Aus3D/z-probe/Resources/v130_top.PNG

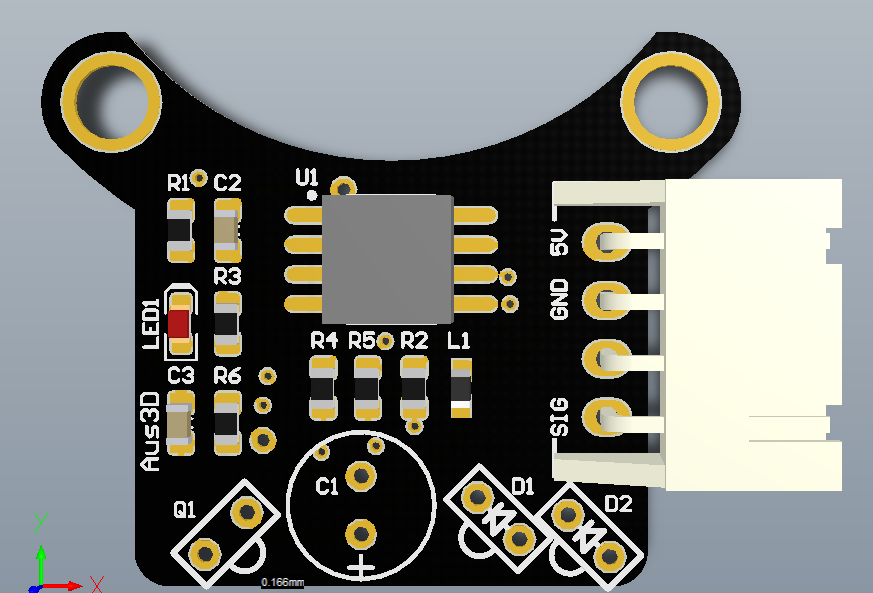
Resources/v130_top.PNG
