Aus3D/z-probe/Resources/v140_top.PNG

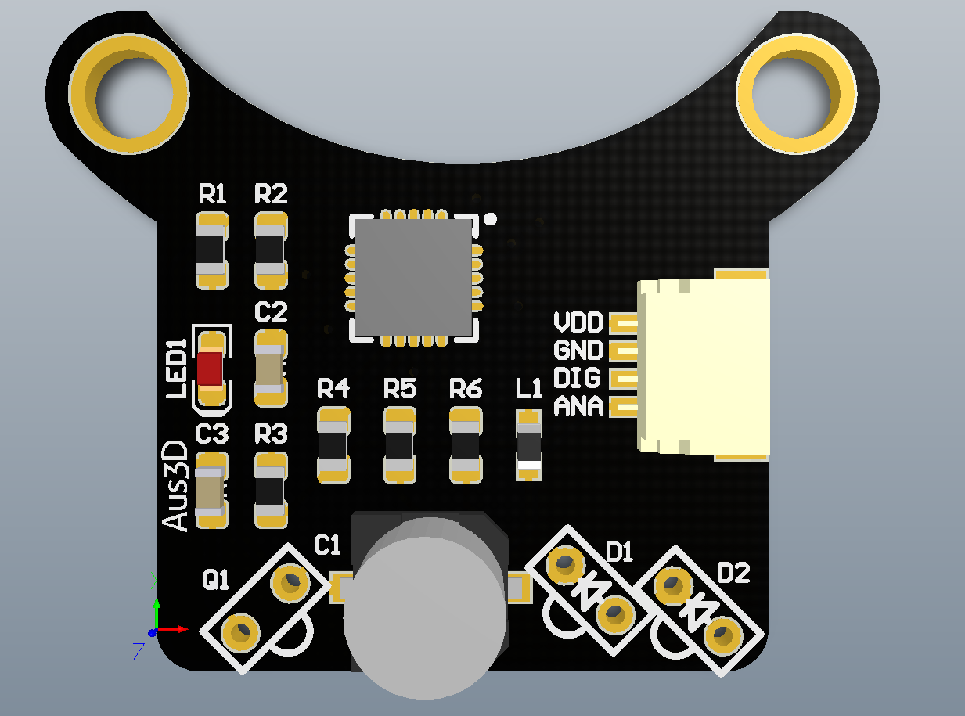
Resources/v140_top.PNG
