Aus3D/z-probe/Resources/v130_bottom.PNG

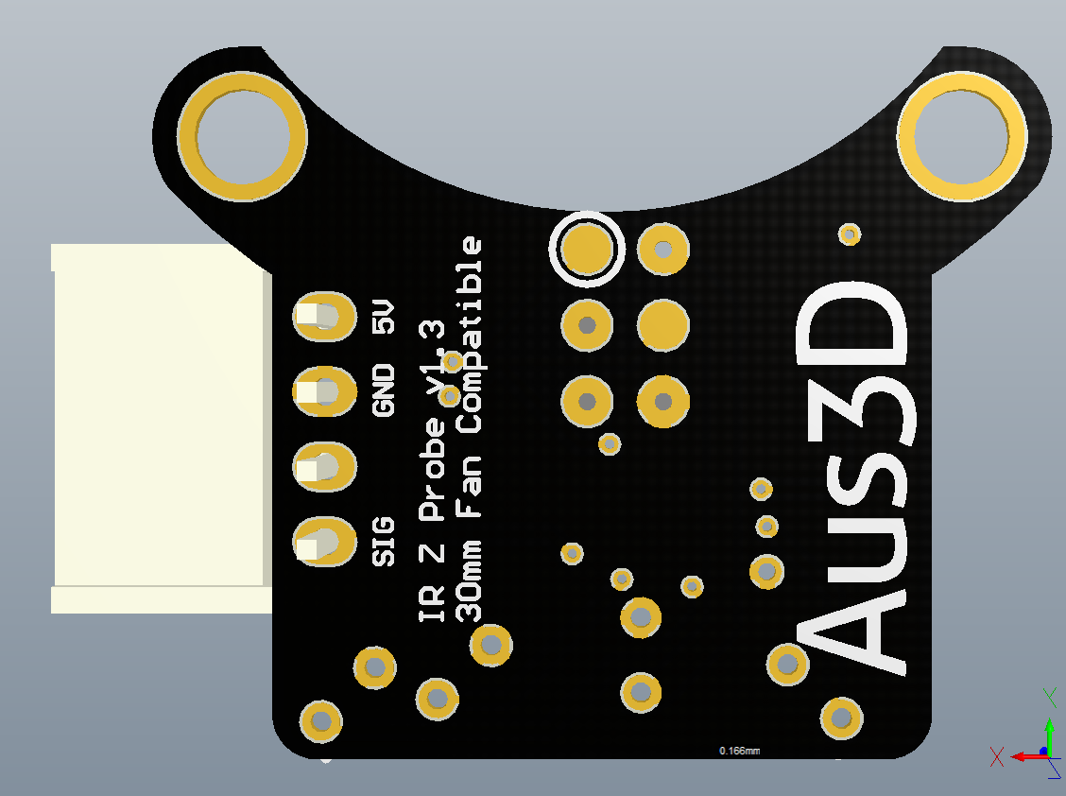
Resources/v130_bottom.PNG
