Aus3D/z-probe/Source/Outputs/irprobe_v141_BOM.xlsx

Designator | Description | Value | Manufacturer 1 | Manufacturer Part Number 1 | Quantity | Substitute | Notes | Supplier 1 | Supplier Part Number 1
C1 | Capacitor THT Electrolytic 20% 16V 100uF | 100u | Kemet | ES5107M016AE1EA | 1 | Approved Sub OK | 5.2-6.0mm Diameter, 5.0-6.5mm Height, 2.5mm pin spacing, 10V or 16V | Digi-Key | 399-6648-1-ND
C2 | Capacitor SMD Cer 100nF 10% 50V X7R 0603 | 100n | AVX Corporation | 06035C104KAT2A | 1 | Approved Sub OK |  | Digi-Key | 478-5052-1-ND
C3 | Capacitor SMD Cer 1nF 10% 100V X7R 0603 | 1n | Murata Electronics North America | GCM188R72A102KA37D | 1 | Approved Sub OK |  | Digi-Key | 490-4780-1-ND
D1, D2 | GL480E |  | Sharp Microelectronics | GL480E00000F | 2 | Approved Sub OK |  | Digi-Key | 425-1940-5-ND
L1 | SMD-Multilayer Inductor WE-MI, L = 1.00 µH | 1uH | TDK Corporation | MLZ1608A1R0M | 1 | Approved Sub OK |  | Digi-Key | 445-3163-2-ND
LED1 | LED 0603 SMD Hyper Red 630nm 220mcd 20mA |  | Kingbright Company LLC | APT1608SURCK | 1 | Approved Sub OK |  | Digi-Key | 754-1123-1-ND
P1 | JST-SH PCB connector side-entry |  | JST Sales America Inc. | SM04B-SRSS-TB(LF)(SN) | 1 | Approved Sub OK |  | Digi-Key | 455-1804-1-ND
Q1 | SFH3100F |  | OSRAM Opto Semiconductors Inc. | SFH 3100 F | 1 | Approved Sub OK |  | Digi-Key | 475-1445-ND
R1 | Resistor SMD chip 330 Ohm 0.1W 5% 0603 | 330R | Vishay Dale | CRCW0603330RJNEA | 1 | Approved Sub OK |  | Digi-Key | 541-330GCT-ND
R2 | Resistor SMD chip 6.8k Ohm 0.1W 5% 0603 | 6K8 | Yageo (https://octopart-clicks.com/click/altium?manufacturer=Panasonic%20Electronic%20Components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) | RC0603JR-072K2L (https://octopart-clicks.com/click/altium?manufacturer=Panasonic%20Electronic%20Components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) | 1 | Approved Sub OK |  | Digi-Key | 311-6.8KGRDKR-ND
R3 | Resistor SMD chip 10k Ohm 0.1W 1% 0603 | 10K | Yageo | RC0603FR-0710KL | 1 | Approved Sub OK |  | Digi-Key | 311-10.0KHRCT-ND
R4 | Resistor SMD chip 12k Ohm 0.1W 1% 0603 | 12K | Yageo | RC0603FR-0710KL | 1 | Approved Sub OK |  | Digi-Key | 311-12.0KHRCT-ND
R5 | Resistor SMD chip 150R Ohm 0.1W 5% 0603 | 150R | Yageo (https://octopart-clicks.com/click/altium?manufacturer=Panasonic%20Electronic%20Components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) | RC0603JR-072K2L (https://octopart-clicks.com/click/altium?manufacturer=Panasonic%20Electronic%20Components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) | 1 | Approved Sub OK |  | Digi-Key | 311-150GRDKR-ND
R6 | Resistor SMD chip 130R Ohm 0.1W 5% 0603 | 130R | Yageo (https://octopart-clicks.com/click/altium?manufacturer=Panasonic%20Electronic%20Components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) | RC0603JR-072K2L (https://octopart-clicks.com/click/altium?manufacturer=Panasonic%20Electronic%20Components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) | 1 | Approved Sub OK |  | Digi-Key | 311-130GRDKR-ND
U1 | 8-bit AVR Microcontroller, 20MHz, 1.8-5.5V, 4KB Flash, 256 Bytes EEPROM, 256 Bytes SRAM, 20-pin MLF, Industrial Grade (-40°C to 85°C), Pb-Free |  | Atmel | ATTINY44A-MU | 1 | Approved Sub OK |  | Digi-Key | ATTINY44A-MU-ND
