Aus3D/z-probe/Resources/3D/irprobe_v140_model.step

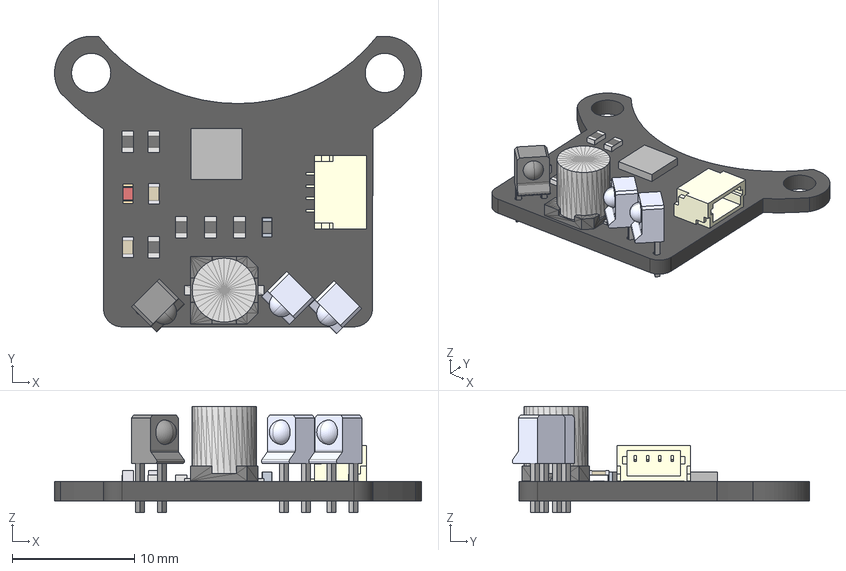
[picture p4: CAD file, 2016-09-13]
Resources/3D/irprobe_v140_model.step
30.0 x 24.3 x 8.69 mm
Board
RES_0603_(1608_metric) x 6
SM04B-SRSS-TB_RGB13434879
through-hole-side-LED_RGB5263440
LED_0603_APT1608_RED
Lötende x 2
Extruded
through-hole-side-LED x 2
CAP_0603 x 2
CAP_EEFK_C
