Aus3D/z-probe/Resources/3D/irprobe_v130_prog_cradle.sldprt

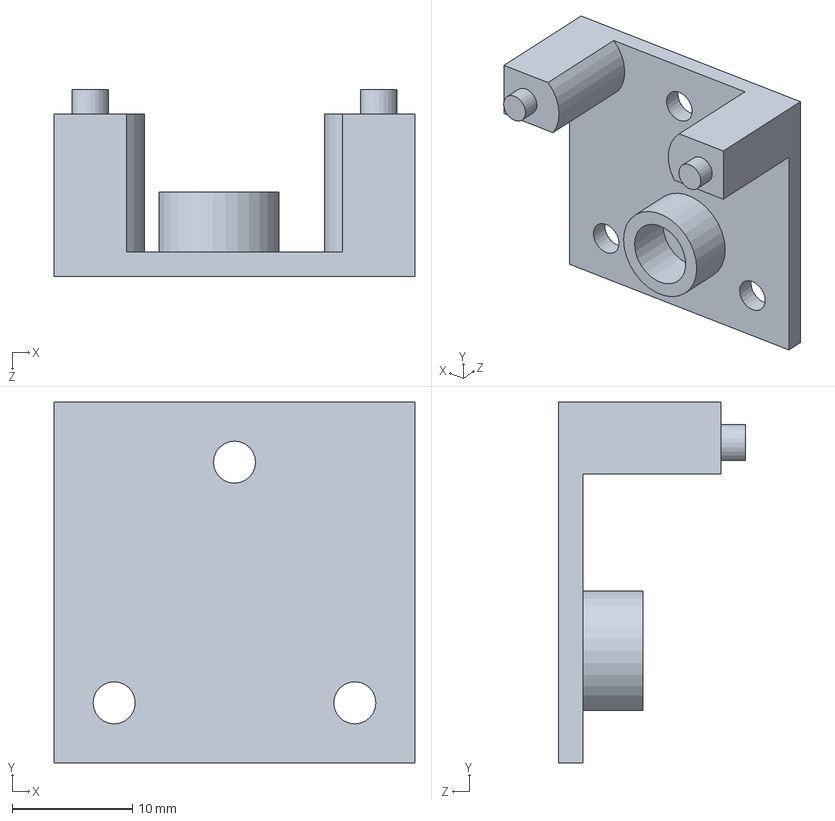
[picture p5: CAD file, 2015-10-24]
Resources/3D/irprobe_v130_prog_cradle.sldprt
30.0 x 30.0 x 15.5 mm
