Aus3D/z-probe/(list of files, cad)

Other CAD files:
Resources/3D/irprobe_v130_prog_cradle.STL
Resources/3D/irprobe_v140_model.STL
