Aus3D/z-probe/schematic.pdf

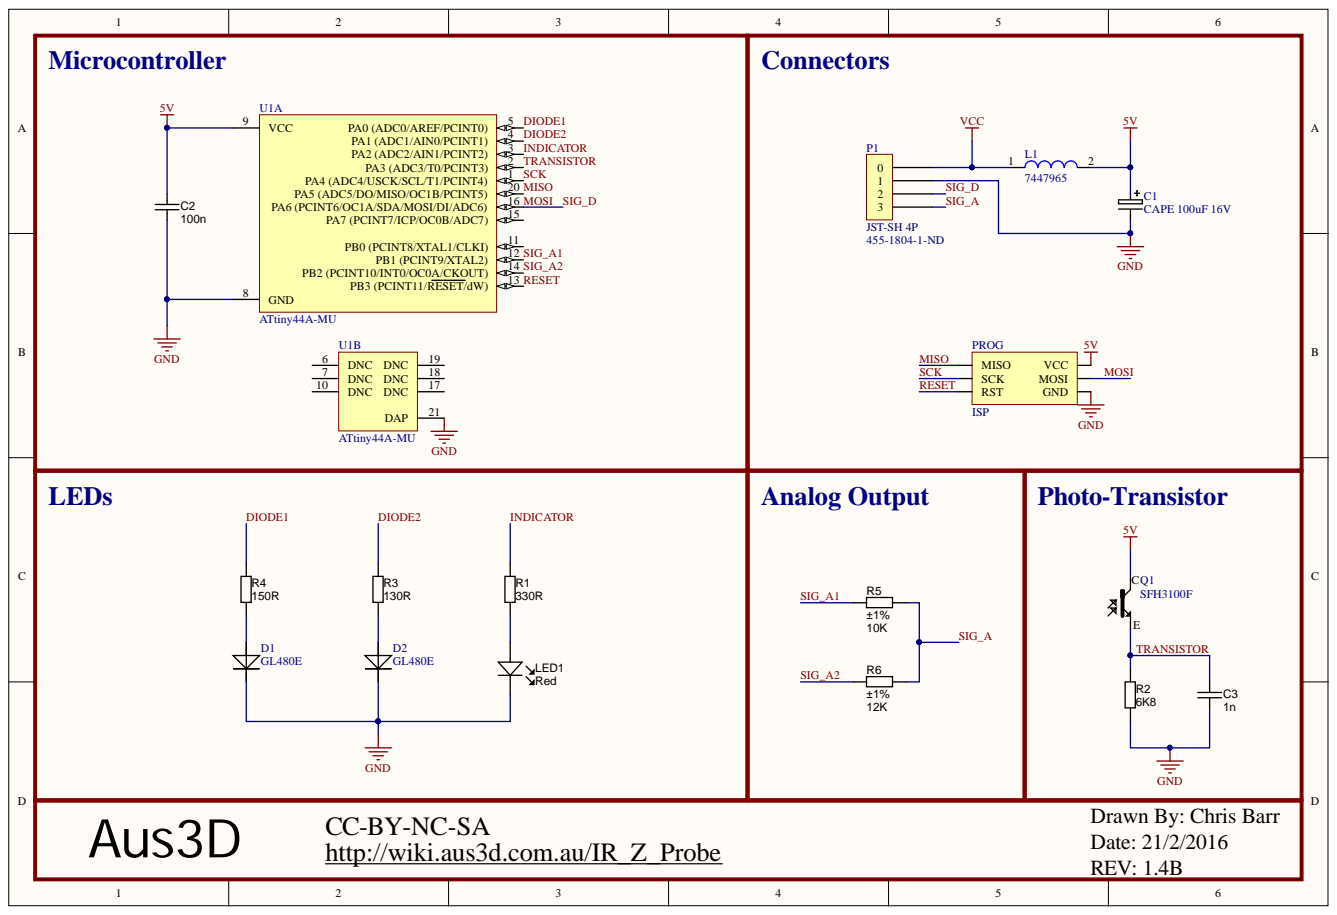
[picture p6: page 1]

http://wiki.aus3d.com.au/IR_Z_Probe
