Aus3D/z-probe/(list of files, drawings)

Other design files:
Source/abl_board.PrjPcb
Source/ir_probe.PcbDoc
Source/ir_probe.PrjPcb
Source/ir_probe.SchDoc
