Aus3D/z-probe/(commit log)

2015-09-12 Initial Commit
    Moving z-probe from Mark2 repository to stand alone repository. Was
    getting tricky to track changes, and things were getting messy.
    [PCB4-2.SLDPRT, PCB4-2.step, PCB4-21.SLDPRT, abl_board.PrjPcb, board1.SchDoc, mini-20mm.PcbDoc, mini-30mm-fan.PcbDoc]
2015-10-24 Added old files
    Added legacy files from development
    [ExtruderZProbe.PrjPcb, IR-Z-Probe.PrjPcb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]
2016-02-19 Work on 1.4A
    Technically ready for manufacture, but I want to play around with it a bit more first. Electrolytic capacitor swapped to SMD, new capacitor saves on height and decreases profile of board. This should make it easier to mount and not worry about collisions etc., board is less likely to be damaged.
    [abl_board.PrjPcb, board1.SchDoc, mini-20mm.PcbDoc, mini-30mm-fan.PcbDoc, z-probe.SchDoc]
2016-02-21 Schematic + PCB draft
    Swapped to ATtiny44A and JST-SH connector.
    [mini-30mm-fan.PcbDoc, z-probe.SchDoc]
2016-02-24 Production Ready
    Files for first batch of updated design.
    [1-4-mini-30mm-fan-BOM-updated.xlsx, 1-4-mini-30mm-fan-pick-place.csv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]
2016-09-13 3D models
    Update PCB with models for most components
    [aus3d-ir-z-probe.STL, aus3d-ir-z-probe.step, mini-30mm-fan.PcbDoc, mini-30mm-fan.step, mini-30mm-fan1.STL]
2019-02-16 Add v1.41 files
    [1-4-mini-30mm-fan-BOM-updated.xlsx, abl_board.PrjPcb, mini-30mm-fan.PcbDoc, v141-zprobe-bom.xlsx, v141-zprobe-pickplace.csv, z-probe.SchDoc]
2019-02-16 Tidying repository
    [ExtruderZProbe.PrjPcb, IR-Z-Probe.PrjPcb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]
2019-02-16 Further tidying
    [ir_probe.PcbDoc, ir_probe.PrjPcb, ir_probe.SchDoc, v130-zprobe-bom.xlsx, v130-zprobe-pickplace.csv, v140-zprobe-bom.xlsx, v140-zprobe-pickplace.csv, v141-zprobe-bom.xlsx]
2019-02-16 Rename output files
    For consistency with other projects
    [irprobe_v130_BOM.xlsx, irprobe_v130_pickplace.csv, irprobe_v140_BOM.xlsx, irprobe_v140_pickplace.csv, irprobe_v141_BOM.xlsx, irprobe_v141_pickplace.csv]
